yacinehrc/L-erreurscope/Images/Avancées/Projet/assemblage_boite.jpg

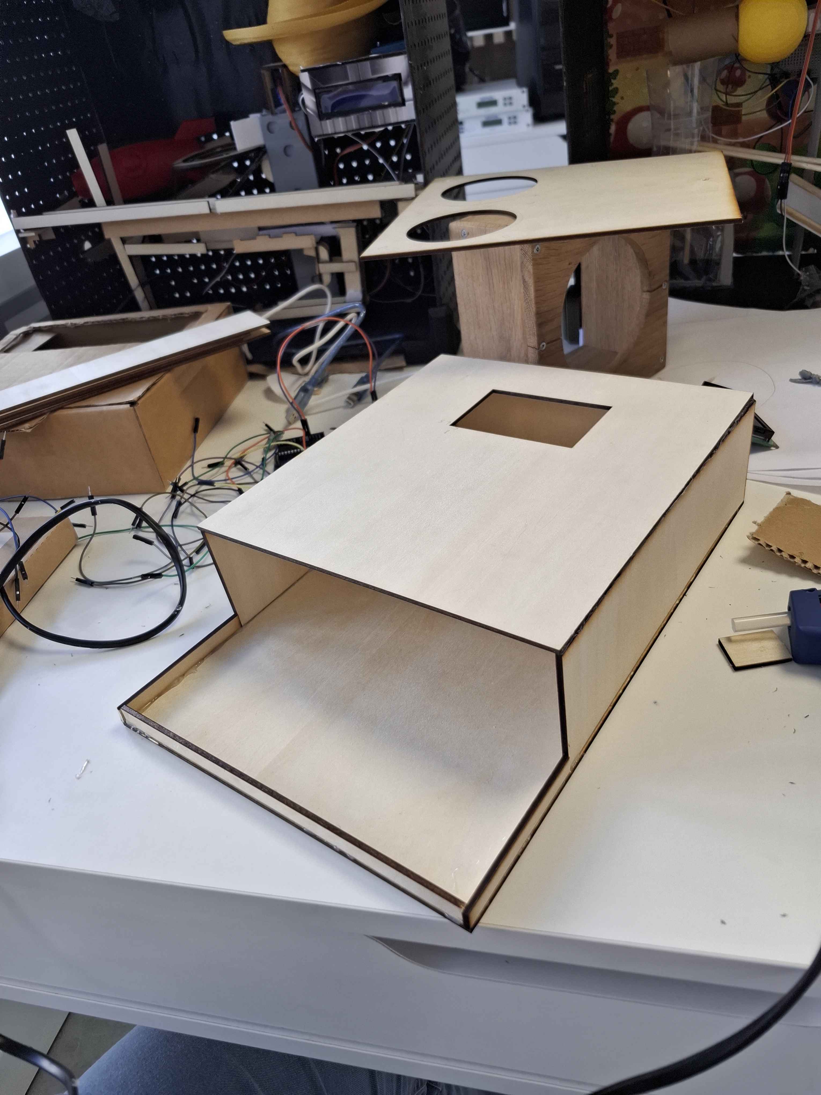
Images/Avancées/Projet/assemblage_boite.jpg
