yacinehrc/L-erreurscope/Images/Avancées/Projet/architecture_boite.jpg

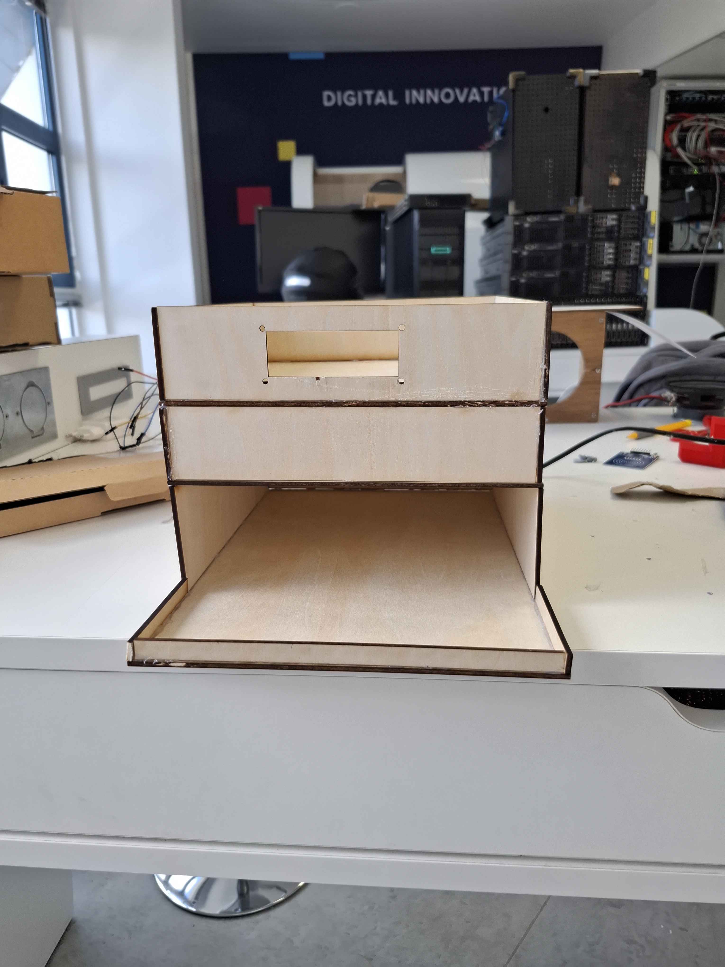
Images/Avancées/Projet/architecture_boite.jpg
