yacinehrc/L-erreurscope/Documentation/Dimensions - Boîte.pdf

Cyril P. Gauthier B. Louis A. Théo B. Yacine H.

L’erreurscope | Workshop B2 - EPSI Lille

# DIMENSION DE LA BOÎTE

## Sommaire

Introduction | 3
1. Étage 1 | 4
1.1 Surface | 4
1.2 Contours (L) | 4
1.3 Contours (l) | 5
2. Étage 2 | 6
2.1 Surface | 6
2.2 Contours (l) | 6
3. Étage 3 | 7
3.1 Surface | 7
3.2 Contours (L) | 7
3.3 Contours (l) | 7
4. Étage 4 | 9
4.1 Surface | 9
4.2 Contours (L) | 9
4.3 Contours (l) | 9
5. Autres | 11
5.1 Levier du servomoteur | 11
5.2 Découpe pour les hauts-parleur | 11
5.3 Découpe pour les composants | 11
5.4 Trou de fixation au servomoteur | 12
5.5 Trou pour l’écran LCD | 12
5.6 Trous pour les vis de l’écran | 13

## Introduction

Cette documentation détaille les dimensions de la boîte en balsa (0,3 cm d'épaisseur), découpée au laser au myDiL. Les plans ont été optimisés pour minimiser les pertes de matière, les chutes étant conservées pour de futurs ajustements. À noter que le document n'inclut que les perçages réalisés au laser, hors éventuelles retouches manuelles au cutter.

## 1. Étage 1

1.1 Surface

Nombre : 1
Longueur : 31 cm
Largeur : 21 cm

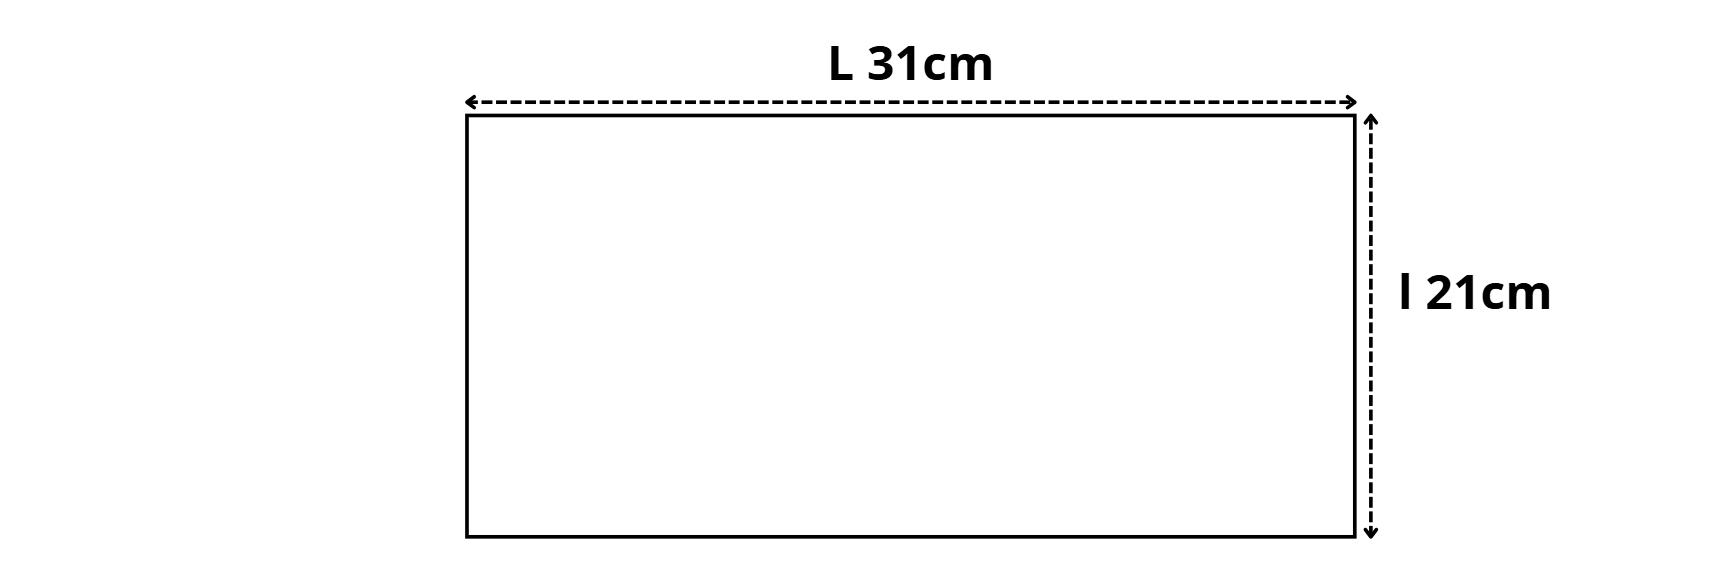
[picture p24: figure]

1.2 Contours (L)

Nombre : 2
Longueur : 8 cm
Hauteur : 1 cm

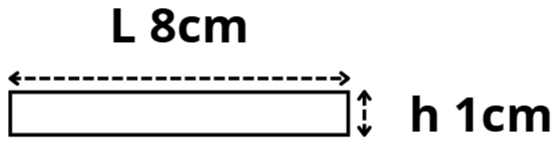
[picture p25: figure]

Nombre : 2
Longueur : 23 cm
Hauteur : 6.6 cm

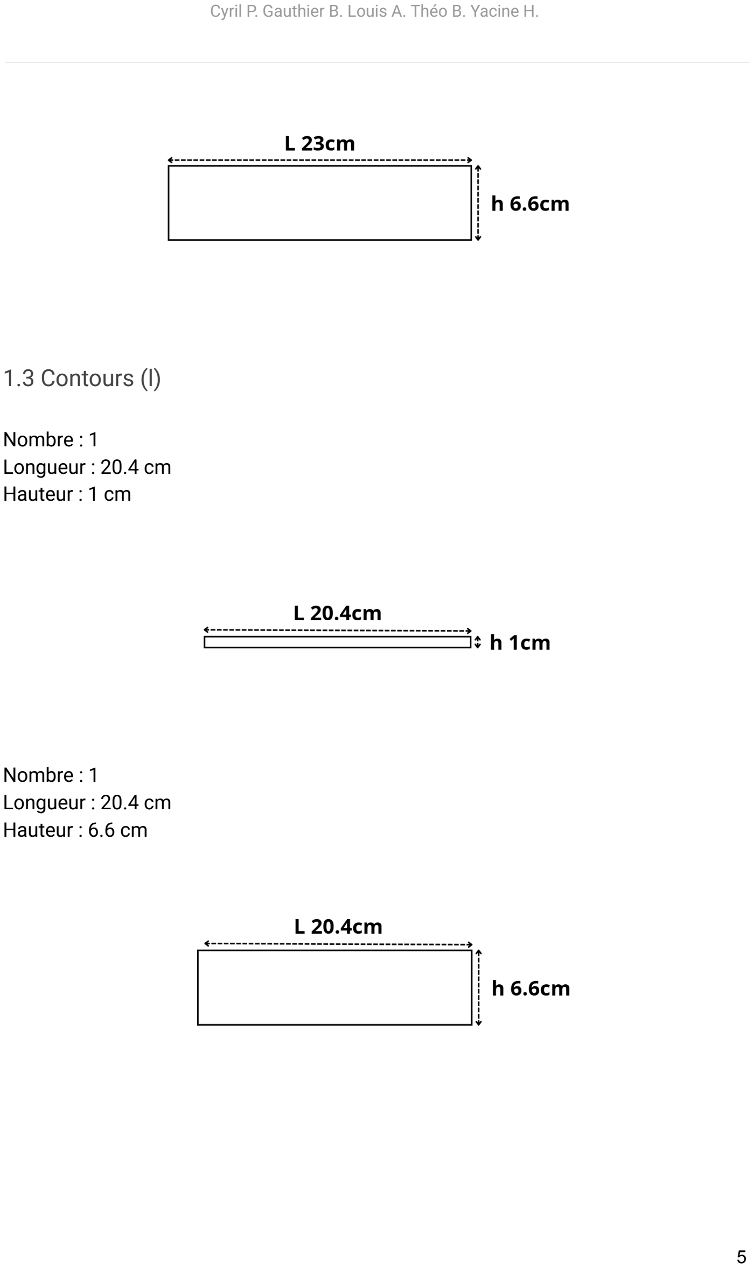
[picture p26: page 5]

1.3 Contours (l)

Nombre : 1
Longueur : 20.4 cm
Hauteur : 1 cm

Nombre : 1
Longueur : 20.4 cm
Hauteur : 6.6 cm

## 2. Étage 2

2.1 Surface

Nombre : 1
Longueur : 21 cm
Largeur : 8.3 cm

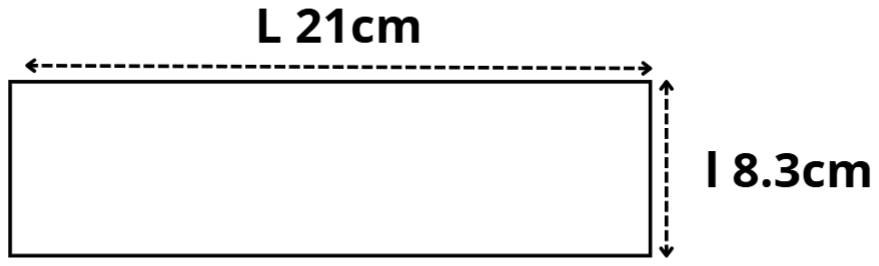
[picture p27: figure]

2.2 Contours (l)

Nombre : 1
Longueur : 21.3 cm
Hauteur : 5 cm

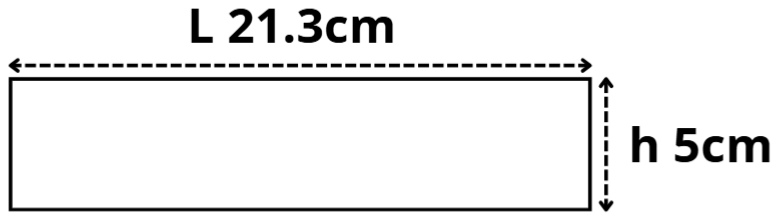
[picture p28: figure]

## 3. Étage 3

3.1 Surface

Nombre : 1
Longueur : 23 cm
Largeur : 21 cm

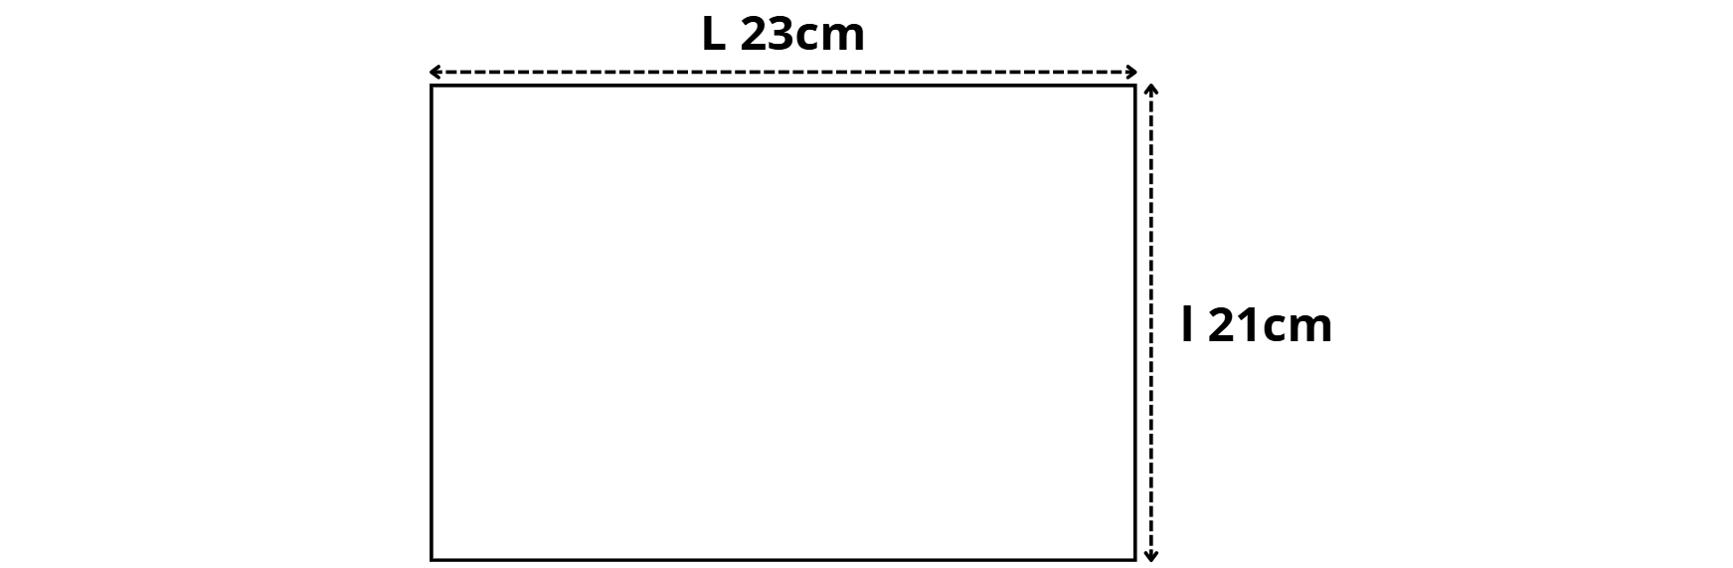
[picture p29: figure]

3.2 Contours (L)

Nombre : 2
Longueur : 23 cm
Hauteur : 5 cm

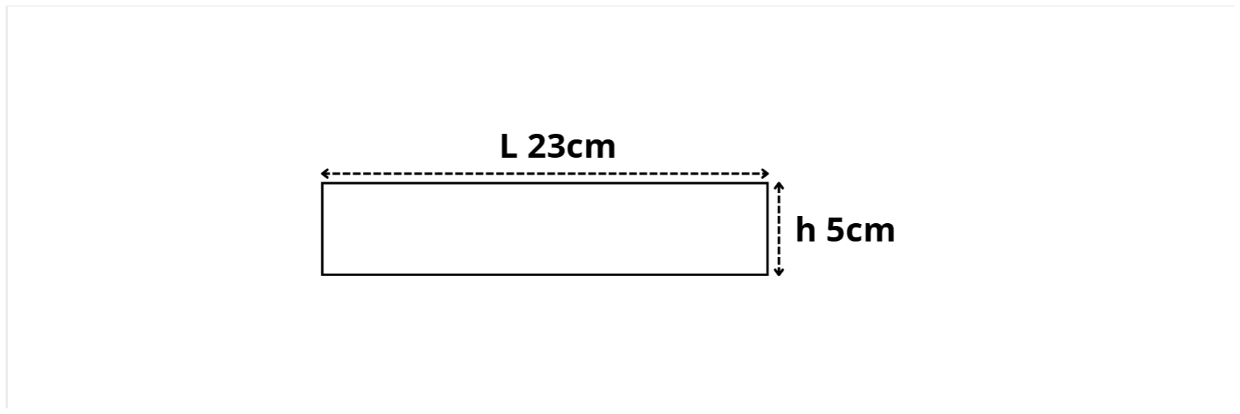
[picture p30: figure]

3.3 Contours (l)

Nombre : 2
Longueur : 20.4 cm
Hauteur : 5 cm

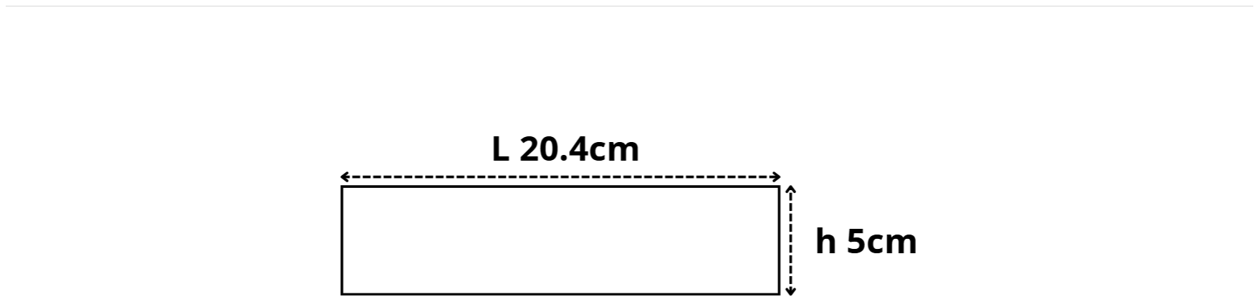
[picture p31: figure]

## 4. Étage 4

4.1 Surface

Nombre : 2
Longueur : 23 cm
Largeur : 21 cm

4.2 Contours (L)

Nombre : 2
Longueur : 23 cm
Hauteur : 4.2 cm

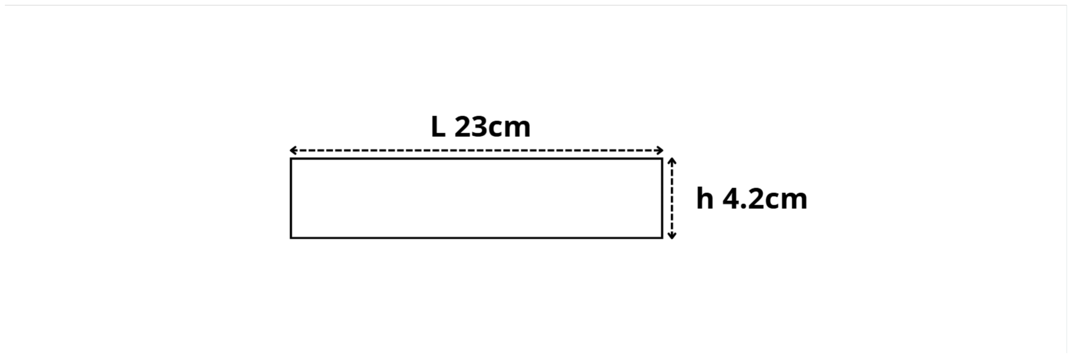
[picture p32: figure]

4.3 Contours (l)

Nombre : 2
Longueur : 20.4 cm
Hauteur : 4.2 cm

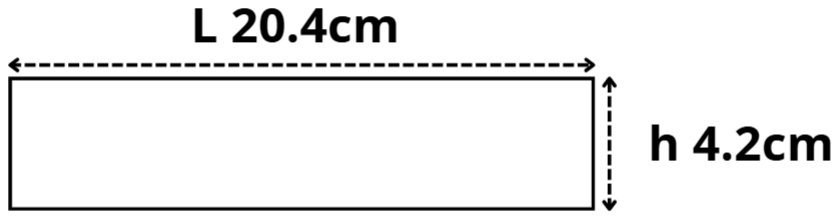
[picture p33: figure]

### 5. Autres

5.1 Levier du servomoteur

Nombre : 1
Longueur : 14.1 cm
Hauteur : 0.7 cm

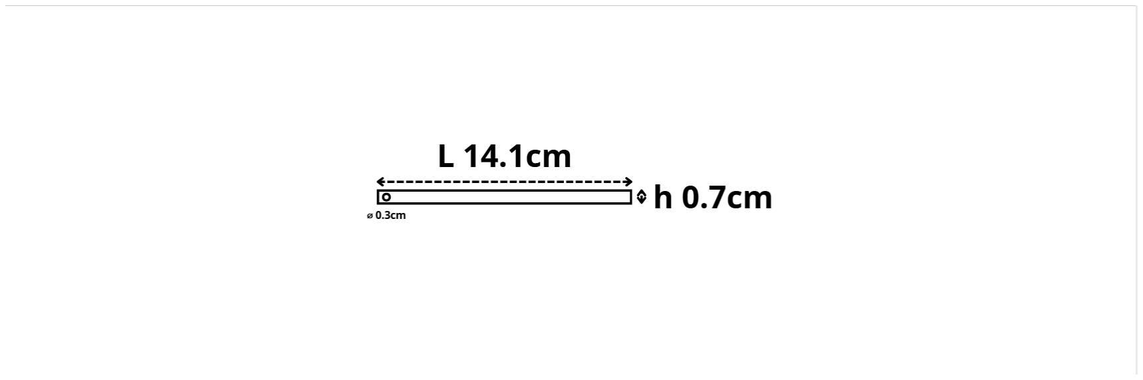
[picture p34: figure]

5.2 Découpe pour les hauts-parleur

Nombre : 2
Diamètre : 7.5cm

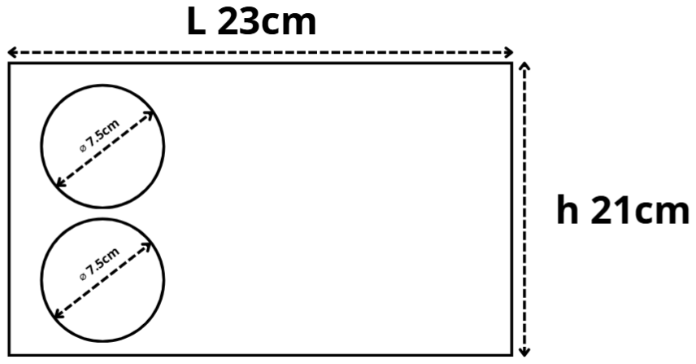
[picture p35: figure]

5.3 Découpe pour les composants

Nombre : 1
Longueur : 8 cm
Largeur : 5 cm

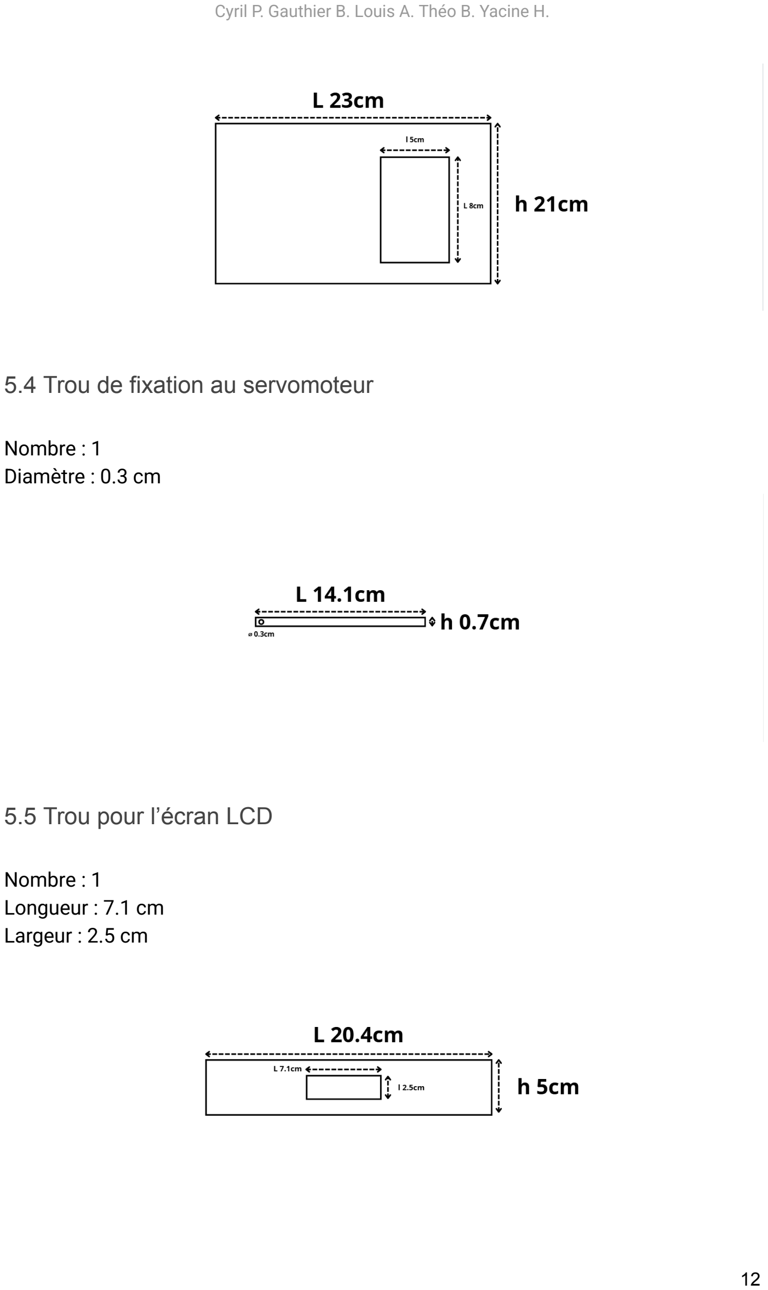
[picture p36: page 12]

5.4 Trou de fixation au servomoteur

Nombre : 1
Diamètre : 0.3 cm

5.5 Trou pour l’écran LCD

Nombre : 1
Longueur : 7.1 cm
Largeur : 2.5 cm

5.6 Trous pour les vis de l’écran

Nombre : 4
Diamètre : 0.3 cm

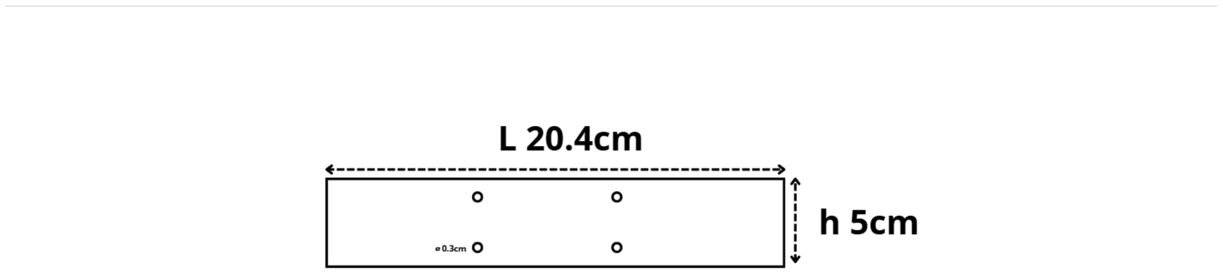
[picture p37: figure]
