yacinehrc/L-erreurscope/Images/Avancées/Projet/boite_finale.jpg

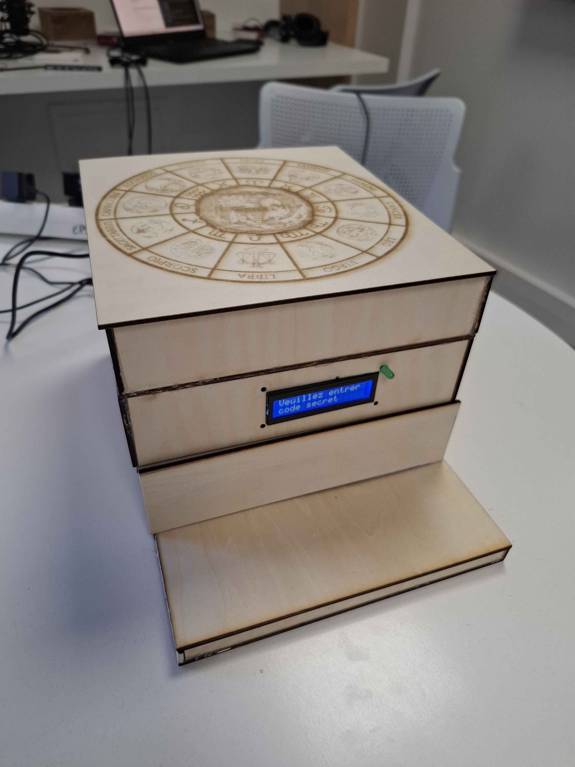
Images/Avancées/Projet/boite_finale.jpg
