yacinehrc/L-erreurscope/Images/Avancées/Projet/boite_visuel_dessus.jpg

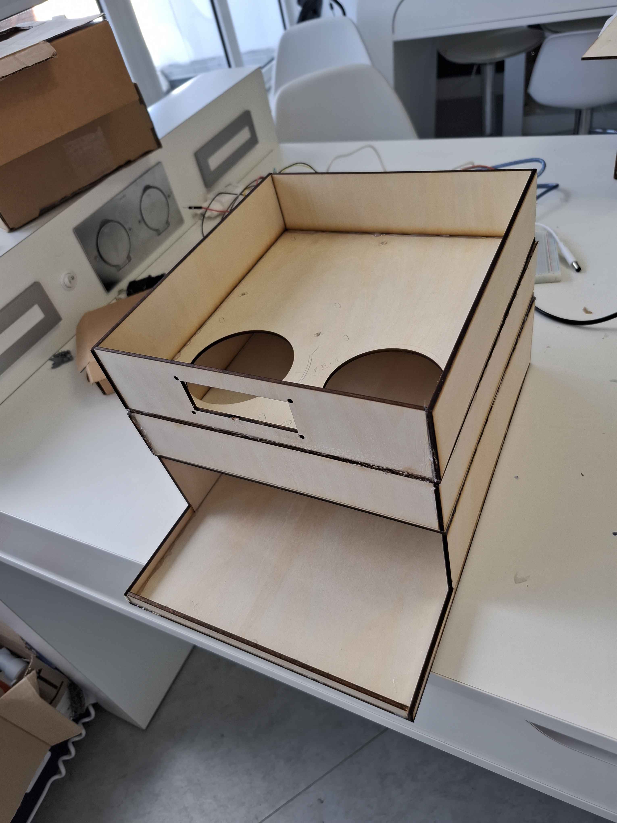
Images/Avancées/Projet/boite_visuel_dessus.jpg
