yacinehrc/L-erreurscope/Images/Avancées/Projet/collage_bois.jpg

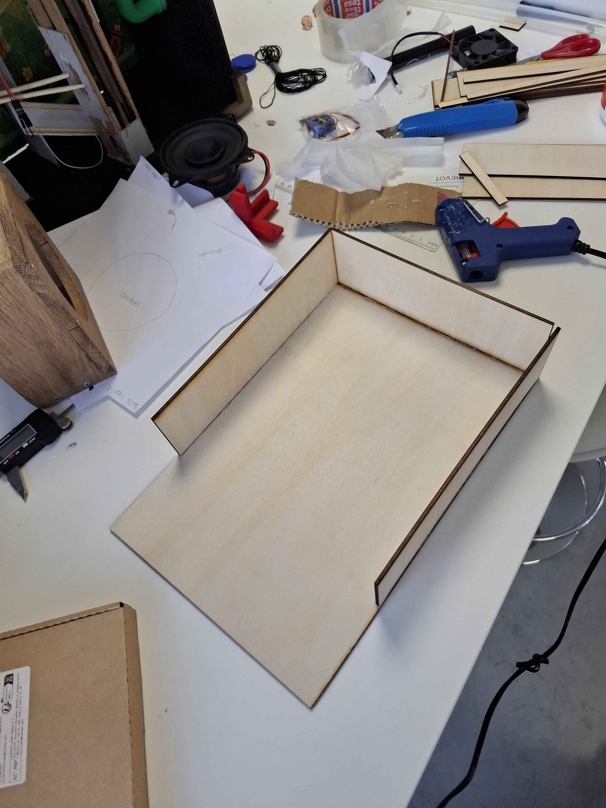
Images/Avancées/Projet/collage_bois.jpg
