yacinehrc/L-erreurscope/Images/Avancées/Projet/decoupe_bois.jpg

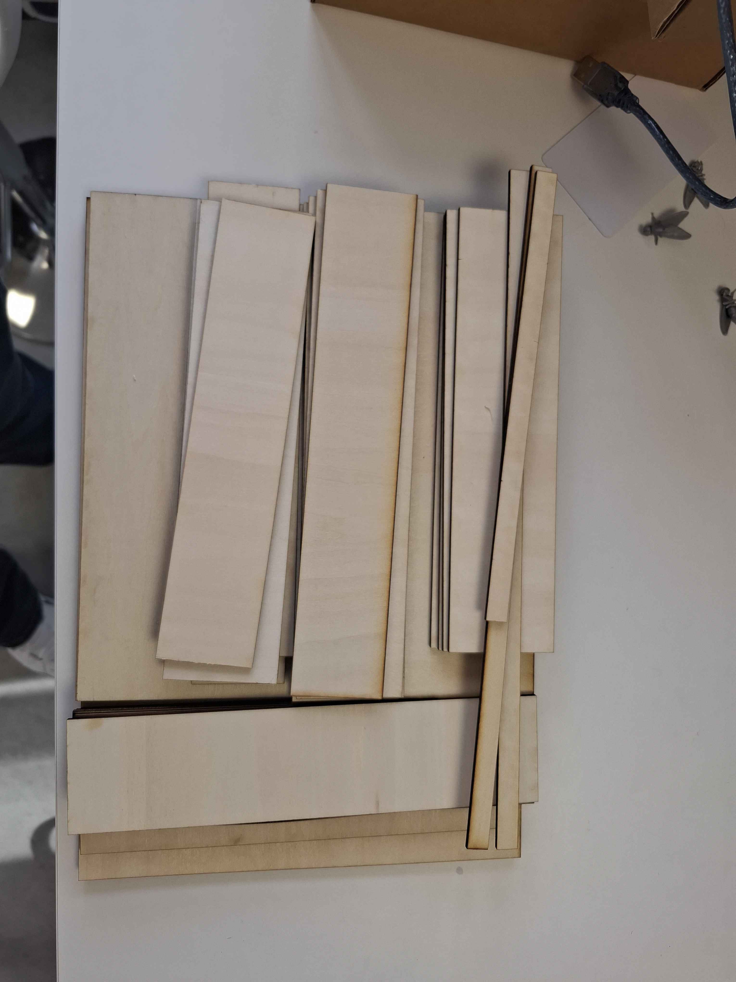
Images/Avancées/Projet/decoupe_bois.jpg
