yacinehrc/L-erreurscope/Images/Avancées/Projet/prototype_boite.jpg

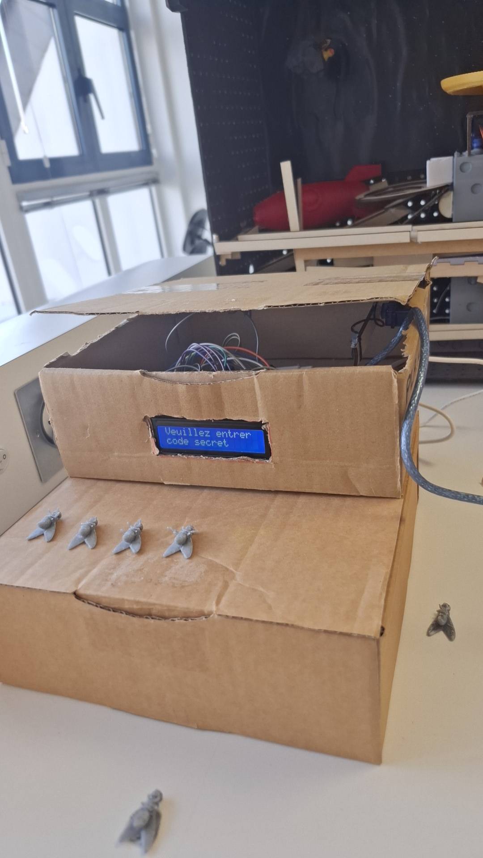
Images/Avancées/Projet/prototype_boite.jpg
