yacinehrc/L-erreurscope/Images/Avancées/Projet/prototype_boite_ouverte.jpg

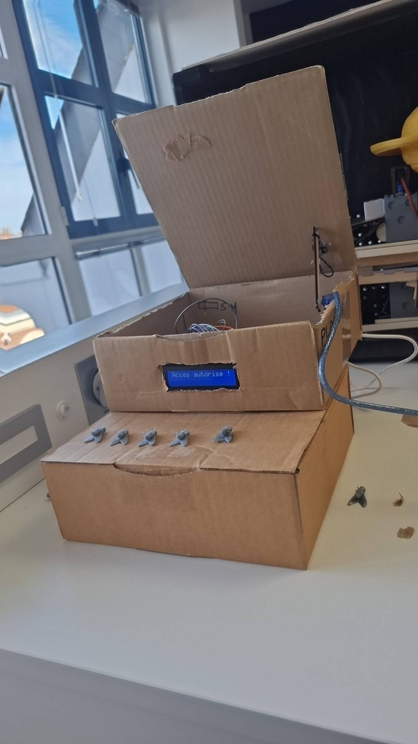
Images/Avancées/Projet/prototype_boite_ouverte.jpg
