yacinehrc/L-erreurscope/Images/Avancées/Tableau Blanc/boite_couches.jpg

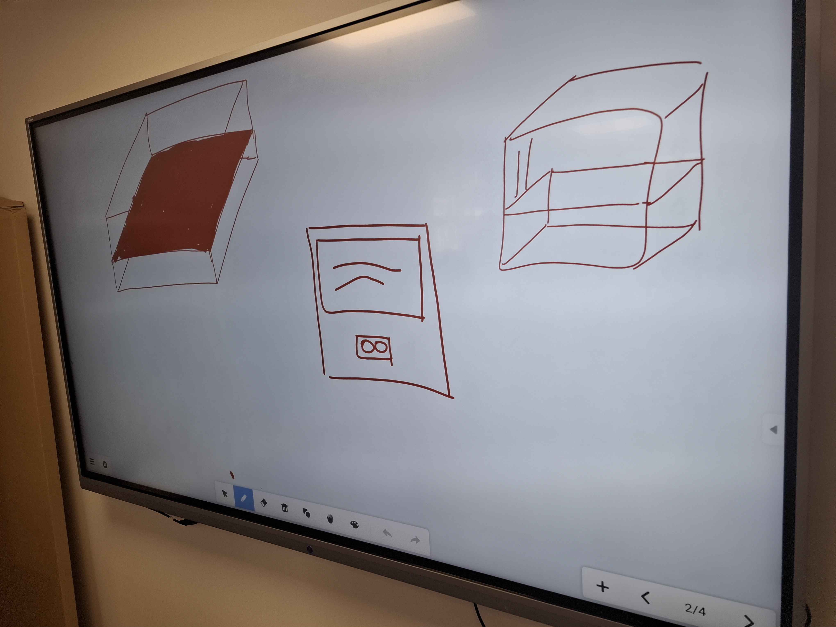
Images/Avancées/Tableau Blanc/boite_couches.jpg
