yacinehrc/L-erreurscope/Images/Avancées/Tableau Blanc/brainstorming_jeudi.jpg

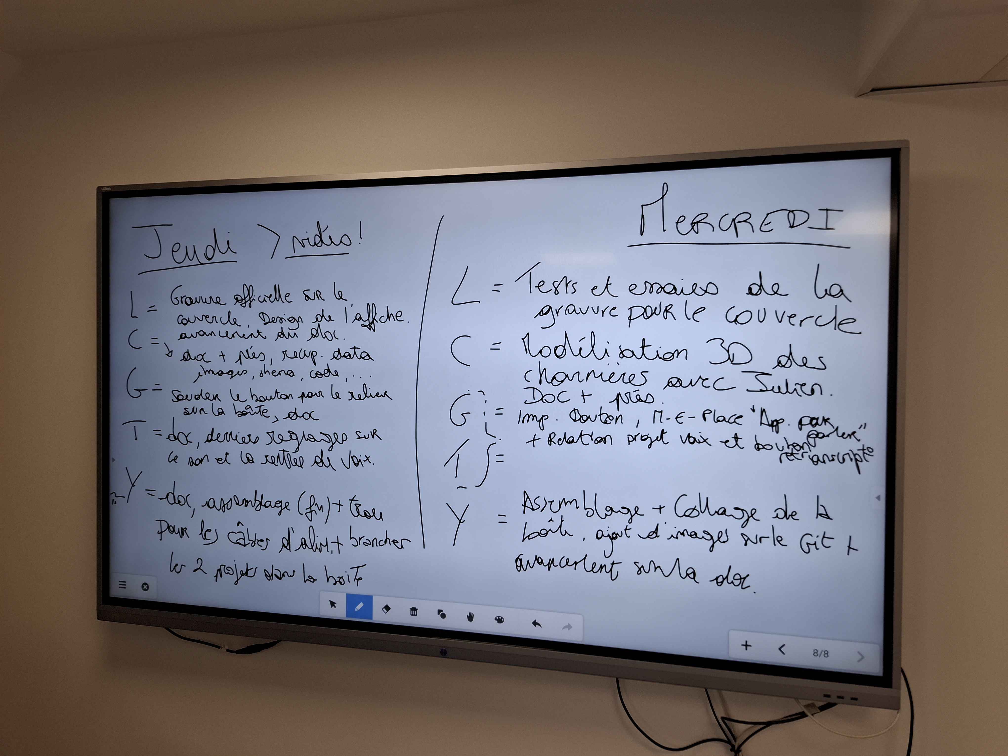
Images/Avancées/Tableau Blanc/brainstorming_jeudi.jpg
