yacinehrc/L-erreurscope/Images/Avancées/Tableau Blanc/brainstorming_mardi.jpg

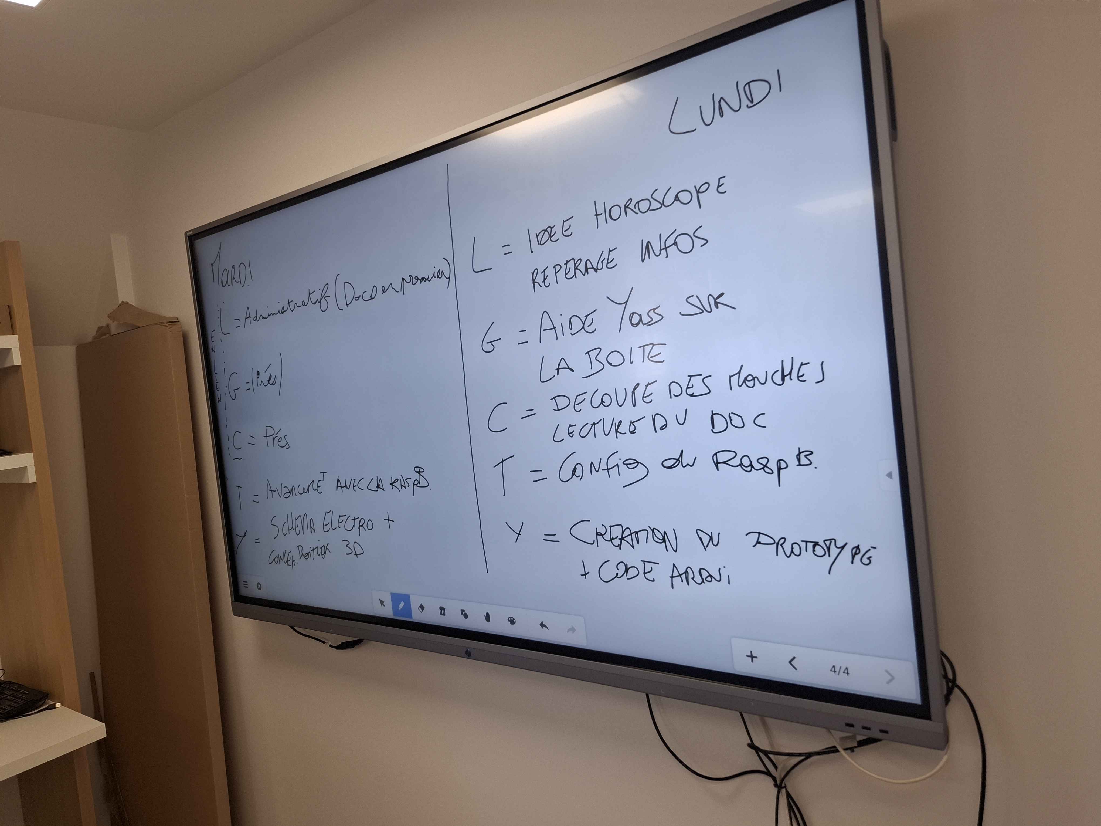
Images/Avancées/Tableau Blanc/brainstorming_mardi.jpg
