yacinehrc/L-erreurscope/Images/Avancées/Tableau Blanc/brainstorming_mercredi.jpg

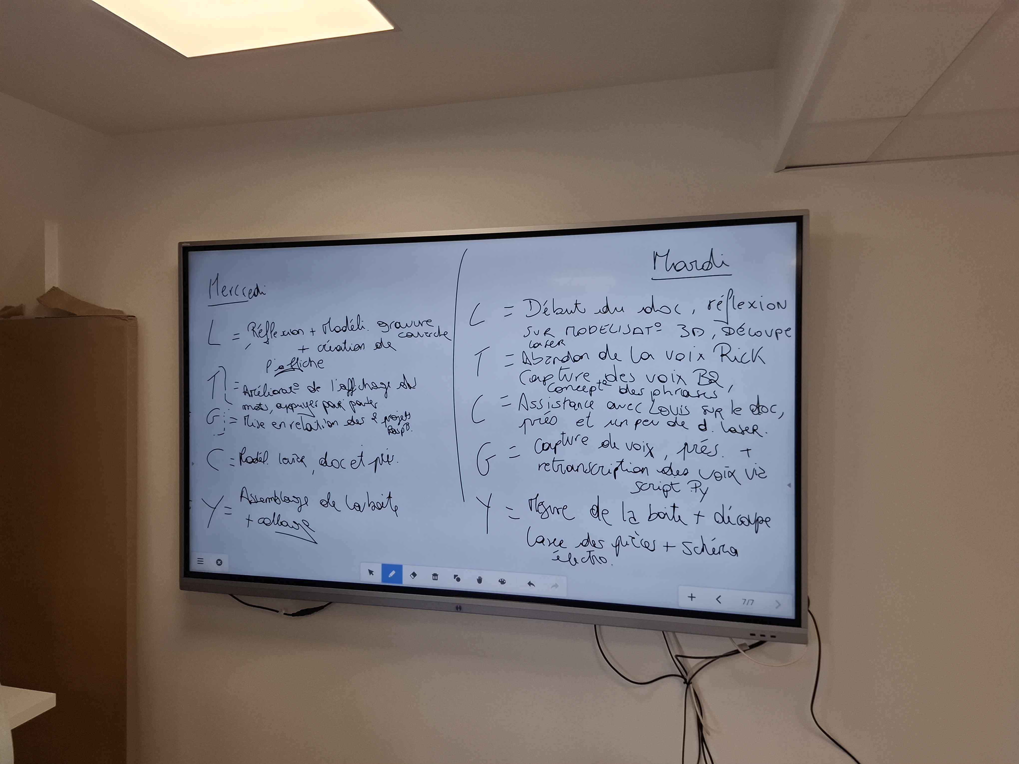
Images/Avancées/Tableau Blanc/brainstorming_mercredi.jpg
