yacinehrc/L-erreurscope/Images/Avancées/Tableau Blanc/mesures_boite.jpg

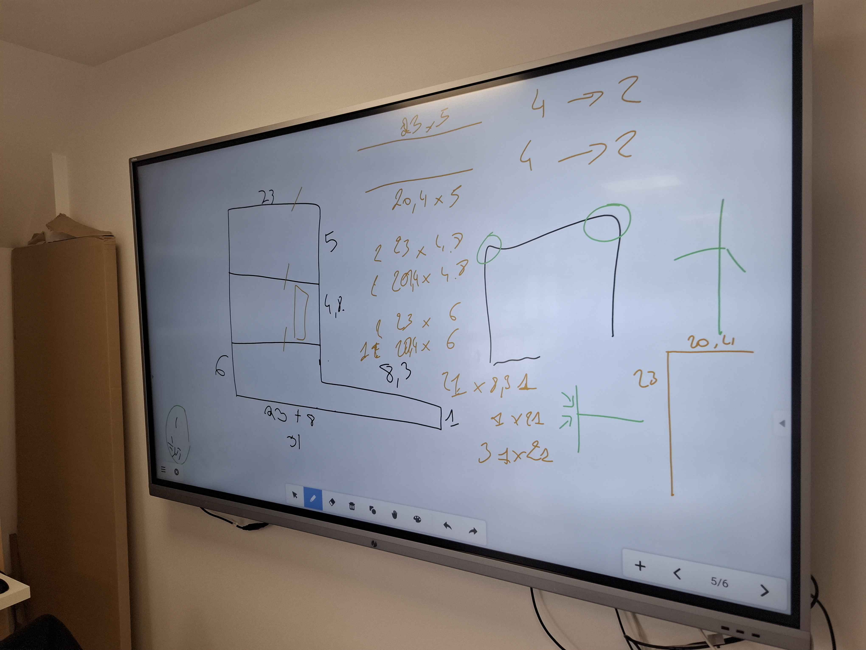
Images/Avancées/Tableau Blanc/mesures_boite.jpg
