yacinehrc/L-erreurscope/Images/Avancées/Tableau Blanc/modelisation_3D.jpg

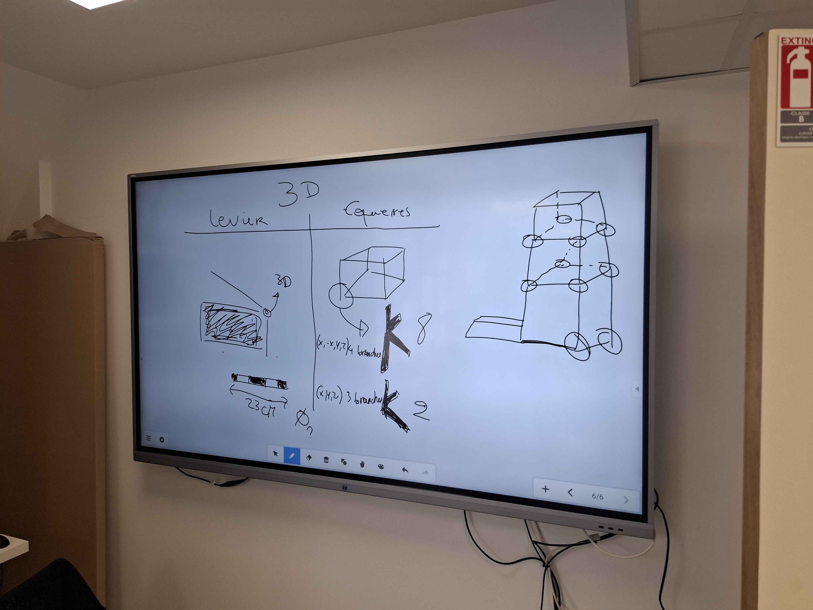
Images/Avancées/Tableau Blanc/modelisation_3D.jpg
