yacinehrc/L-erreurscope/Images/Avancées/Tableau Blanc/prototype_boite.jpg

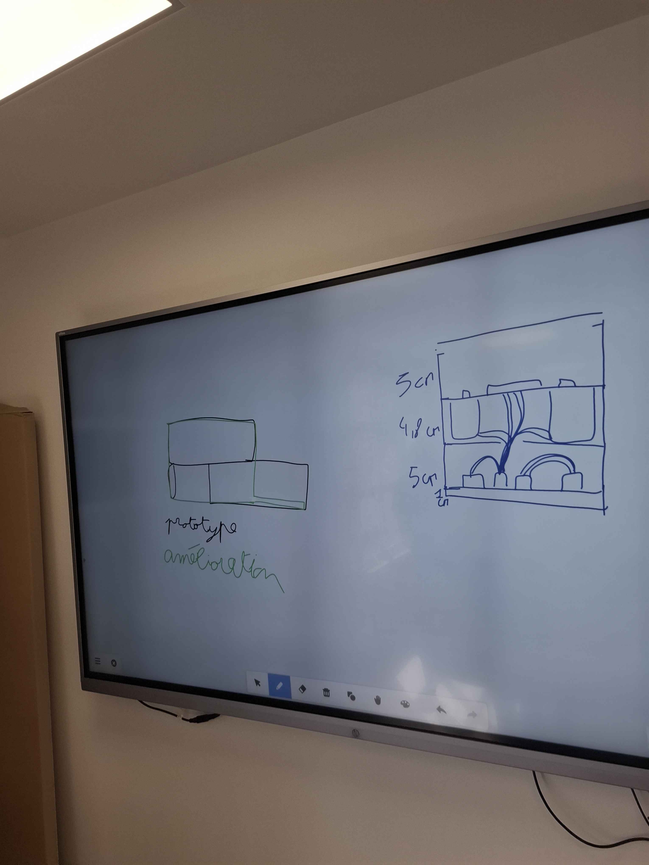
Images/Avancées/Tableau Blanc/prototype_boite.jpg
