yacinehrc/L-erreurscope/Images/Code/Arduino/loop_fermeture.png

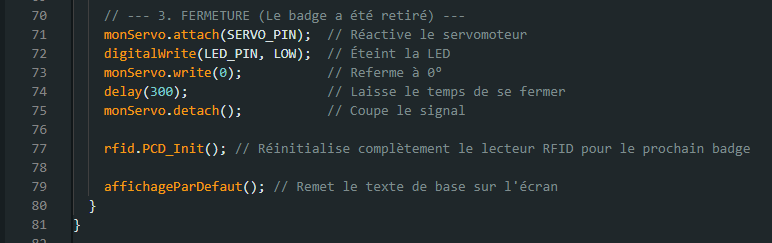
Images/Code/Arduino/loop_fermeture.png
