yacinehrc/L-erreurscope/Images/Erreurscope/Affiche_Erreurscope.jpg

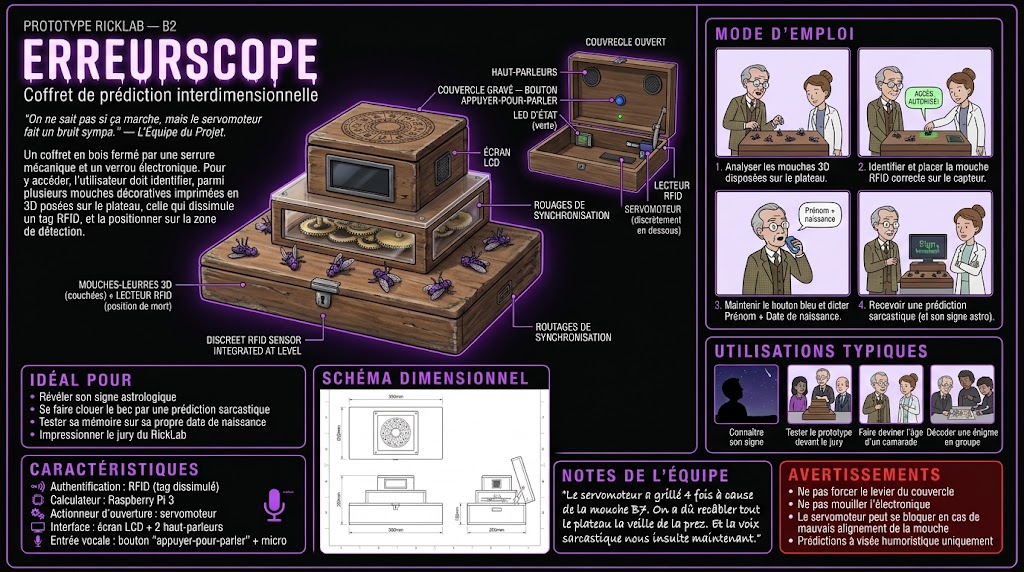
Images/Erreurscope/Affiche_Erreurscope.jpg
