yacinehrc/L-erreurscope/Images/Erreurscope/erreurscope_img.jpg

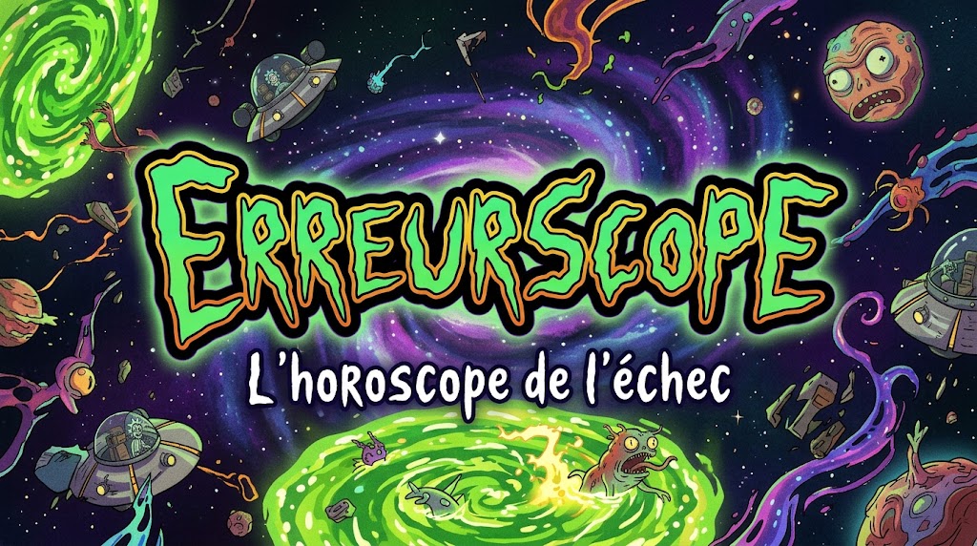
Images/Erreurscope/erreurscope_img.jpg
