yacinehrc/L-erreurscope/Images/Mesures/Autres/decoupe 8x5 cm.png

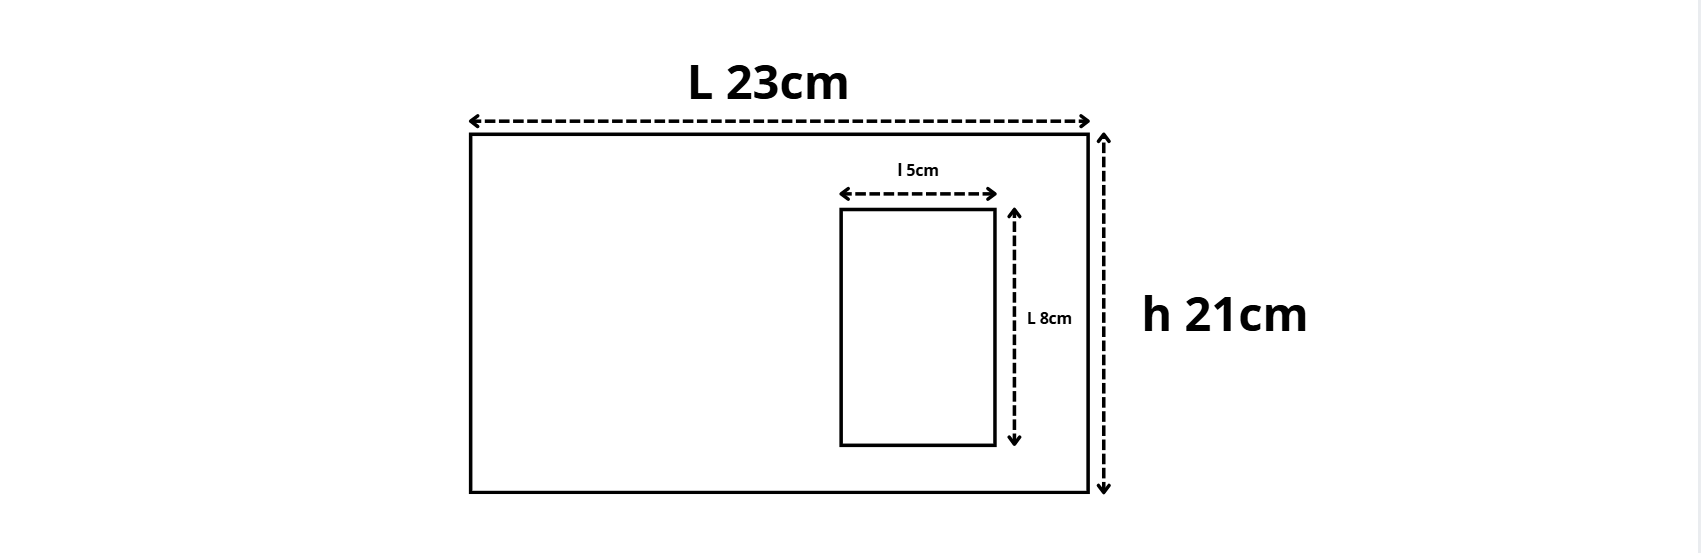
Images/Mesures/Autres/decoupe 8x5 cm.png
