yacinehrc/L-erreurscope/Images/Mesures/Autres/diametre 7.5cm.png

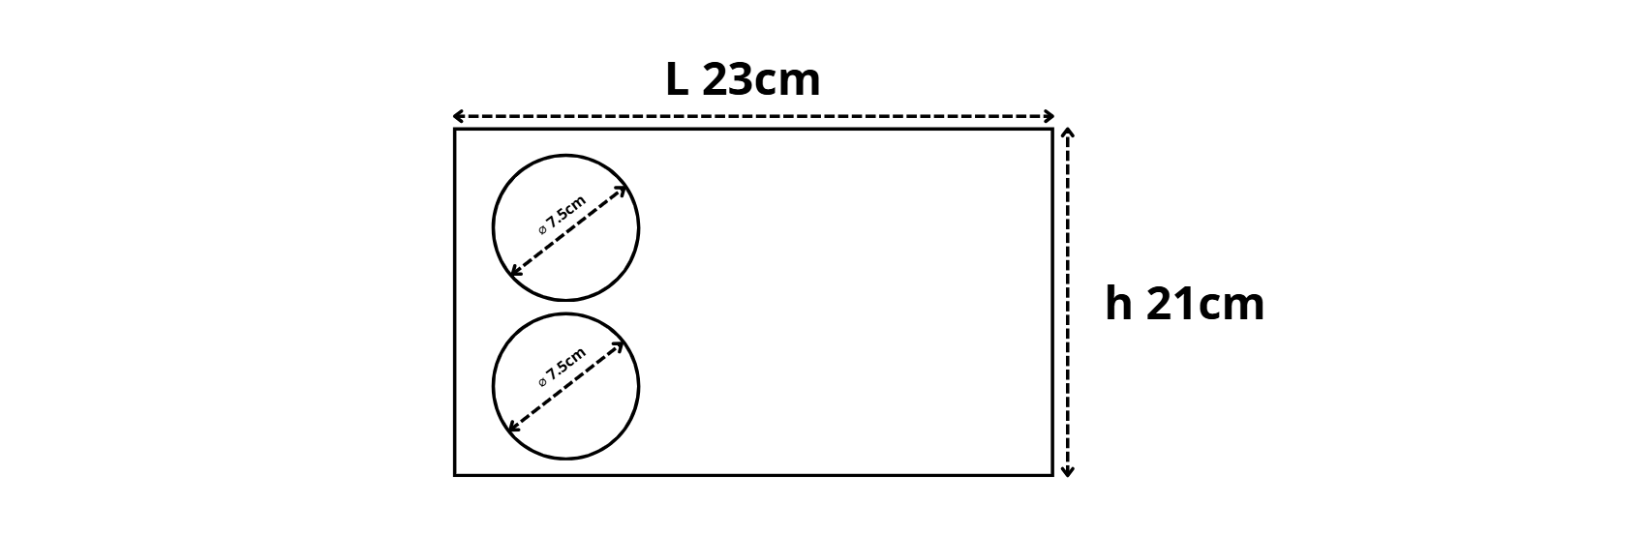
Images/Mesures/Autres/diametre 7.5cm.png
