yacinehrc/L-erreurscope/Images/Mesures/Etage_1/23x6.6 cm.png

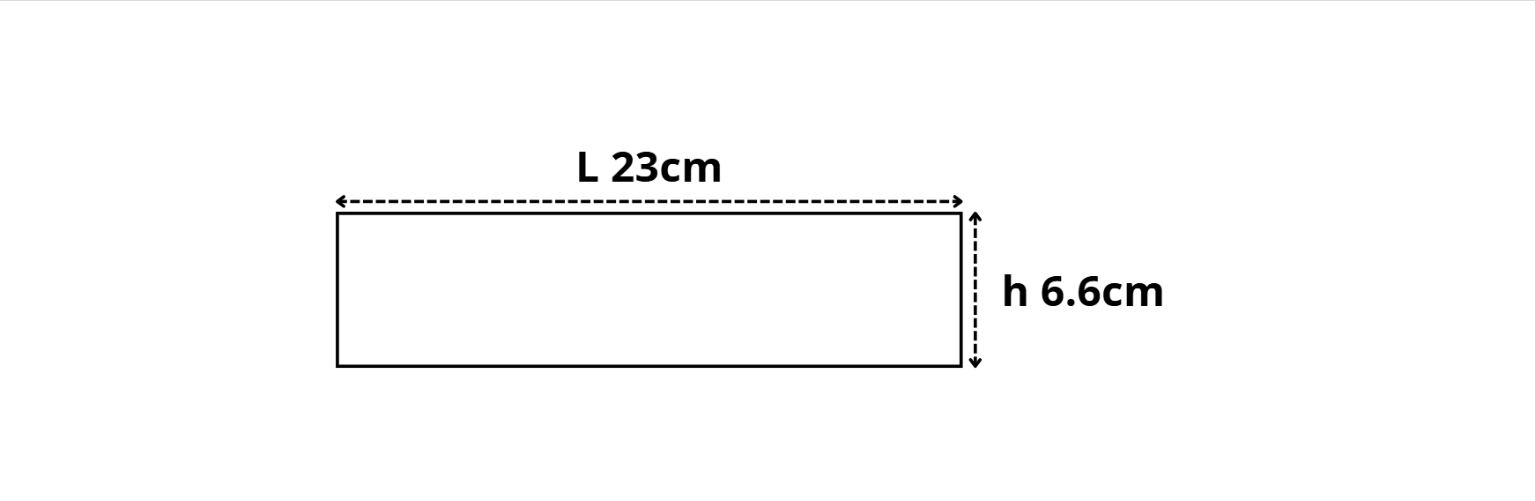
Images/Mesures/Etage_1/23x6.6 cm.png
