yacinehrc/L-erreurscope/Images/Modélisation/3D/boite_jeudi.jpg

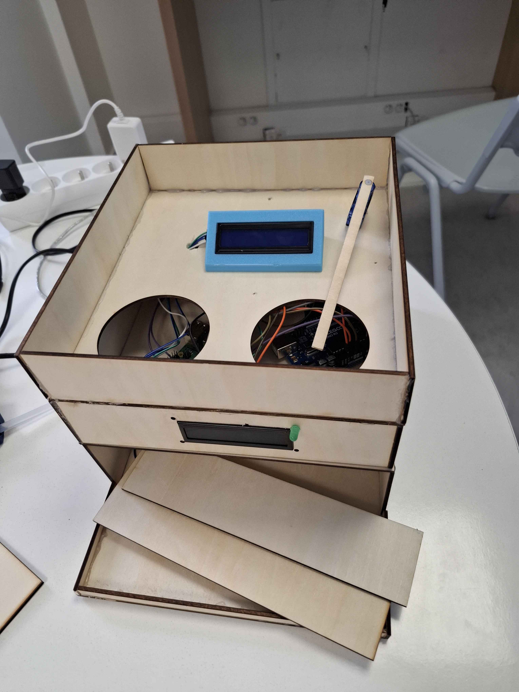
Images/Modélisation/3D/boite_jeudi.jpg
