yacinehrc/L-erreurscope/Images/Modélisation/3D/demi-charniere_3D.jpg

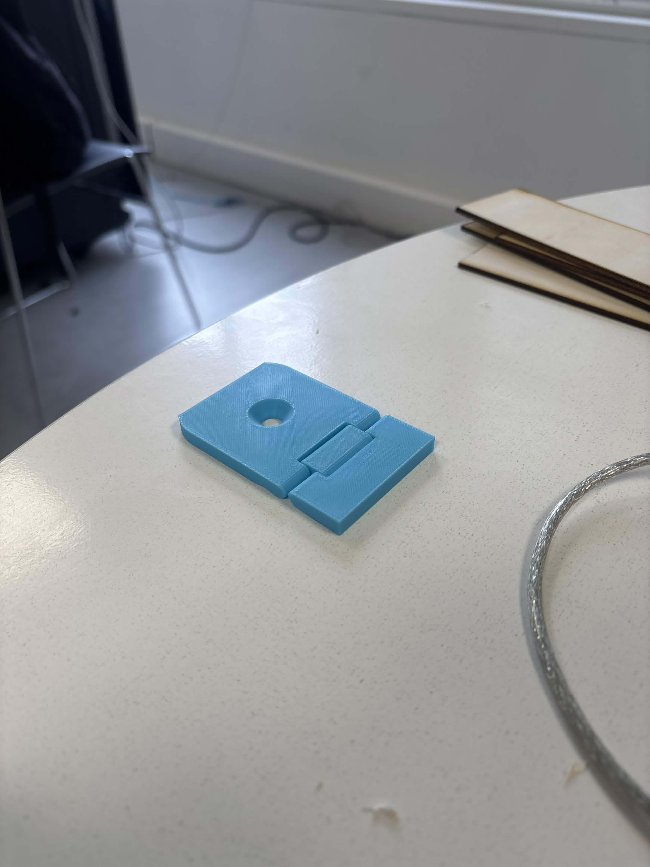
Images/Modélisation/3D/demi-charniere_3D.jpg
