yacinehrc/L-erreurscope/Images/Modélisation/3D/mouches_3D.jpg

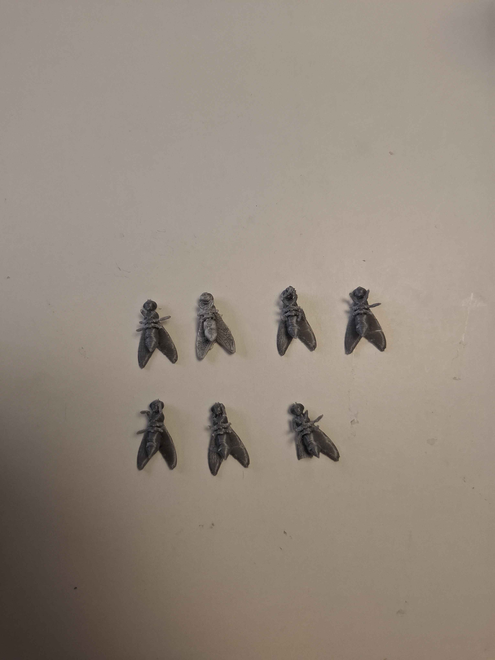
Images/Modélisation/3D/mouches_3D.jpg
