yacinehrc/L-erreurscope/Images/Modélisation/3D/support_ecran_3D.jpg

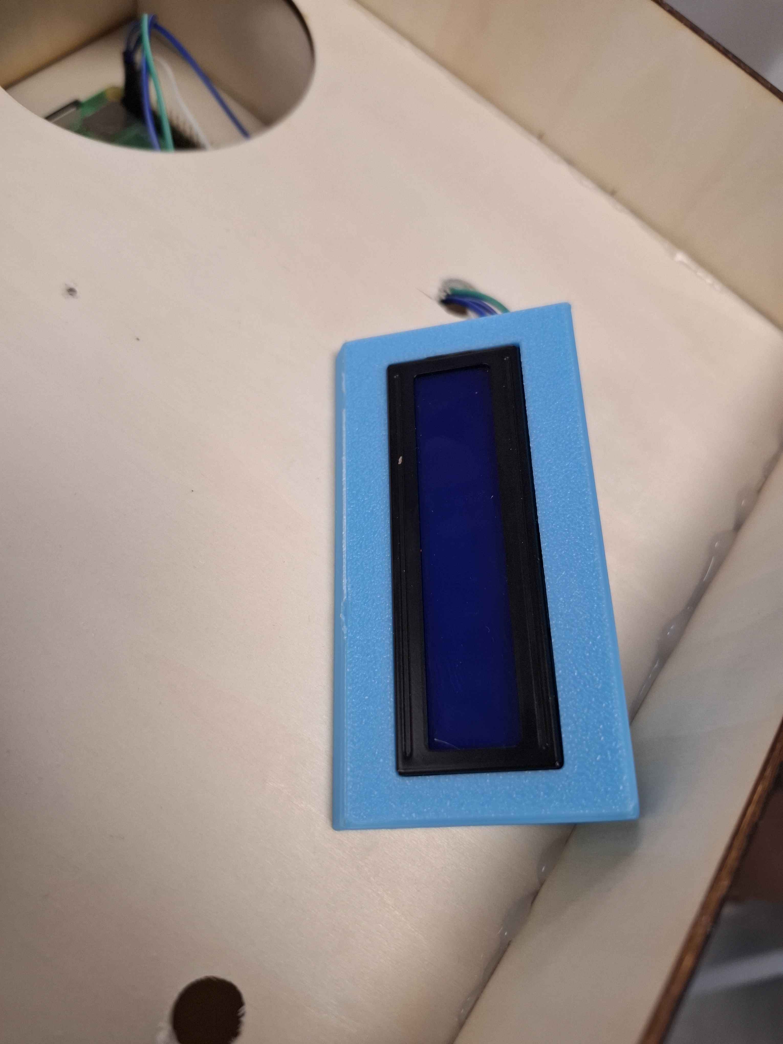
Images/Modélisation/3D/support_ecran_3D.jpg
