yacinehrc/L-erreurscope/Images/Modélisation/Gravure/gravure_couvercle.jpg

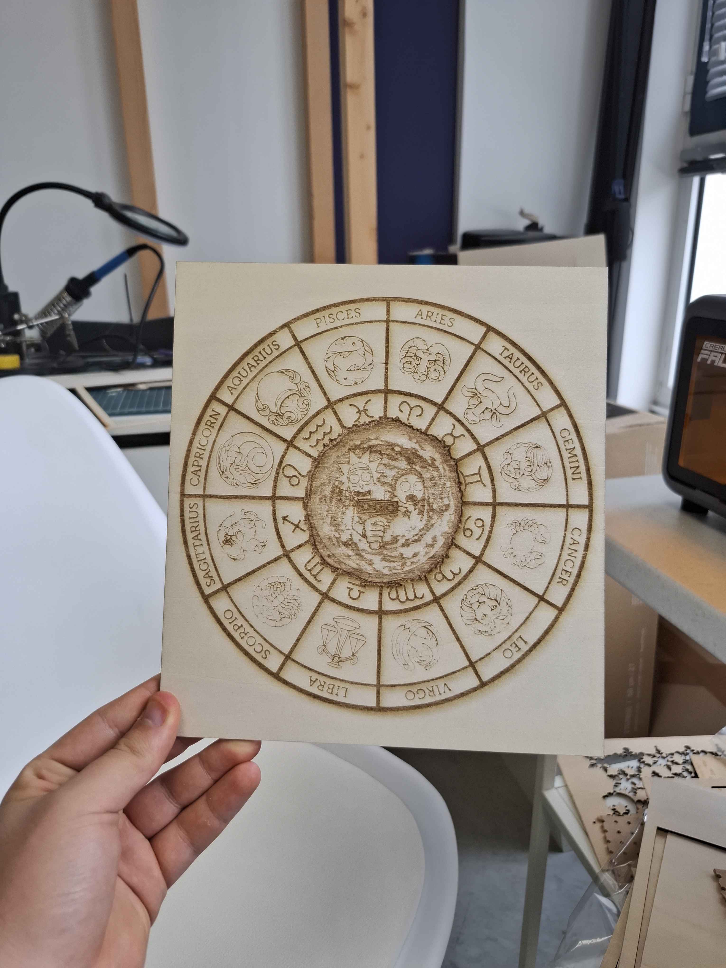
Images/Modélisation/Gravure/gravure_couvercle.jpg
