yacinehrc/L-erreurscope/Images/Schema/Boite/etage_1.png

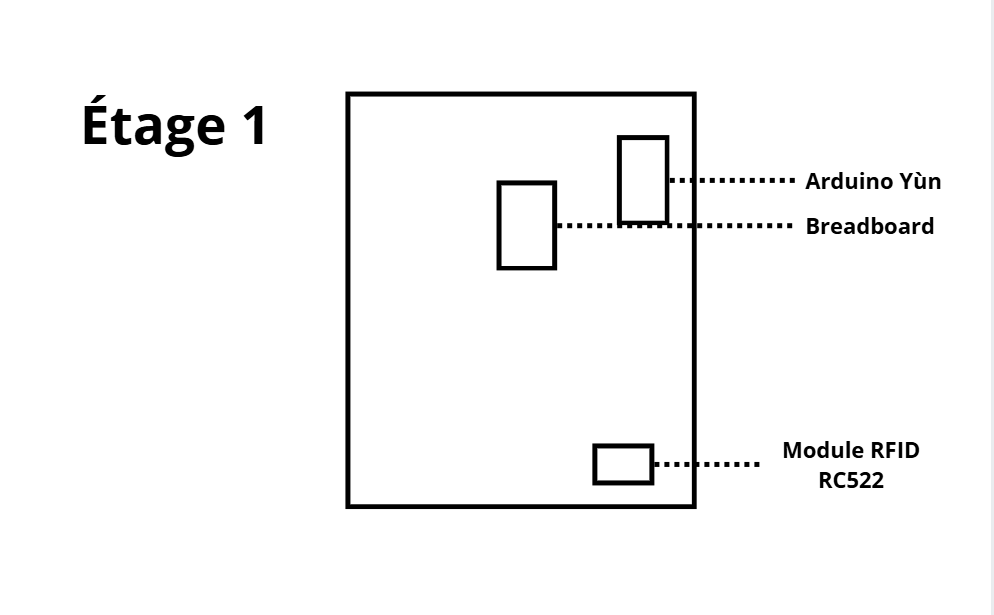
Images/Schema/Boite/etage_1.png
