yacinehrc/L-erreurscope/Images/Schema/Boite/etage_3.png

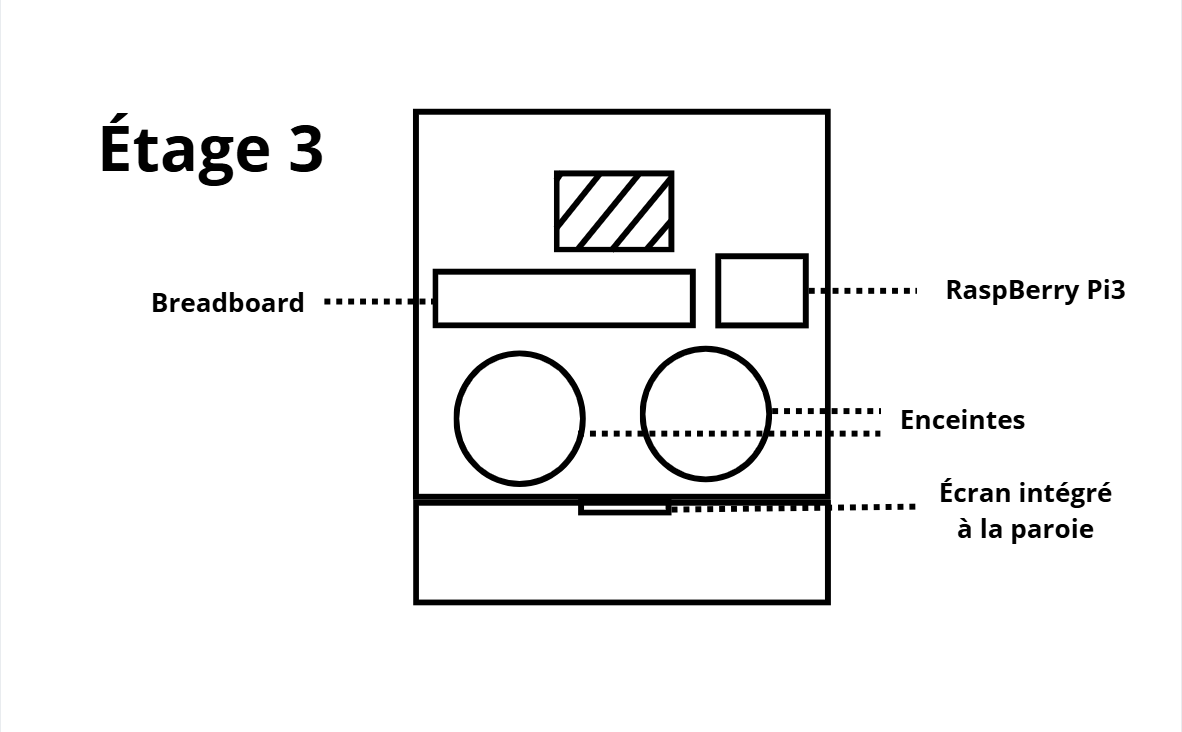
Images/Schema/Boite/etage_3.png
