yacinehrc/L-erreurscope/Images/Schema/Boite/etage_4.png

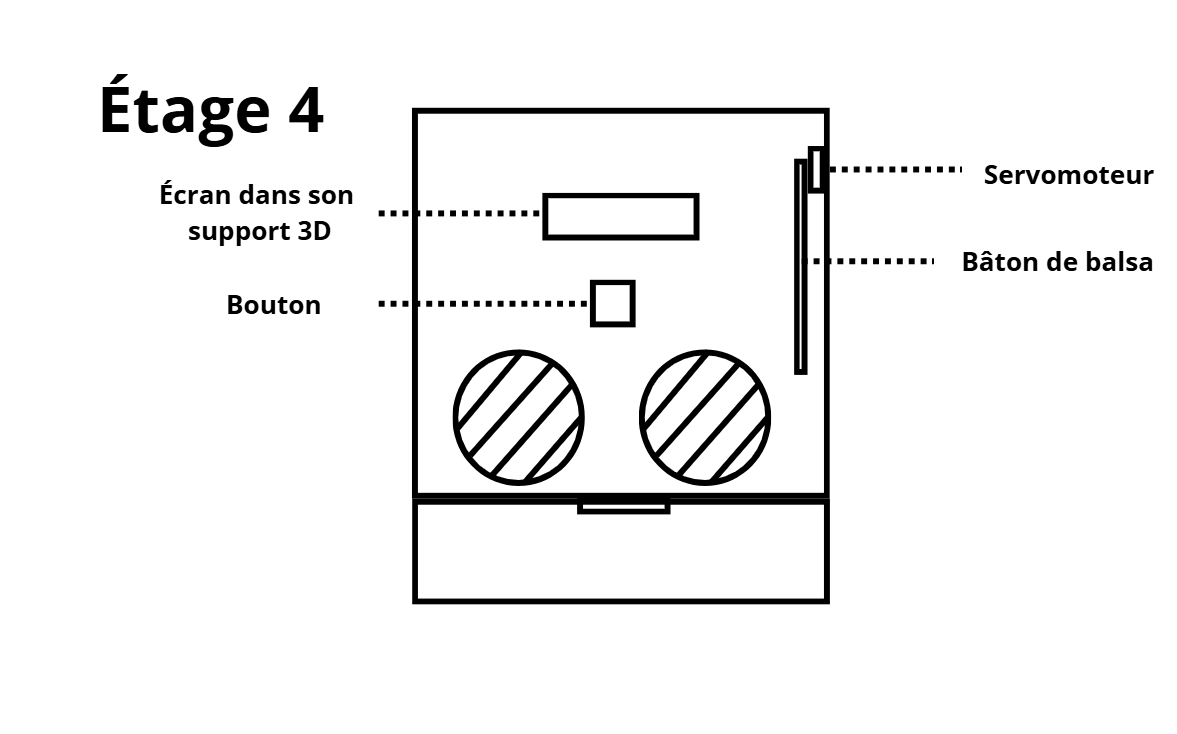
Images/Schema/Boite/etage_4.png
