yacinehrc/L-erreurscope/Images/Schema/Boite/schema_boite_portrait_face.png

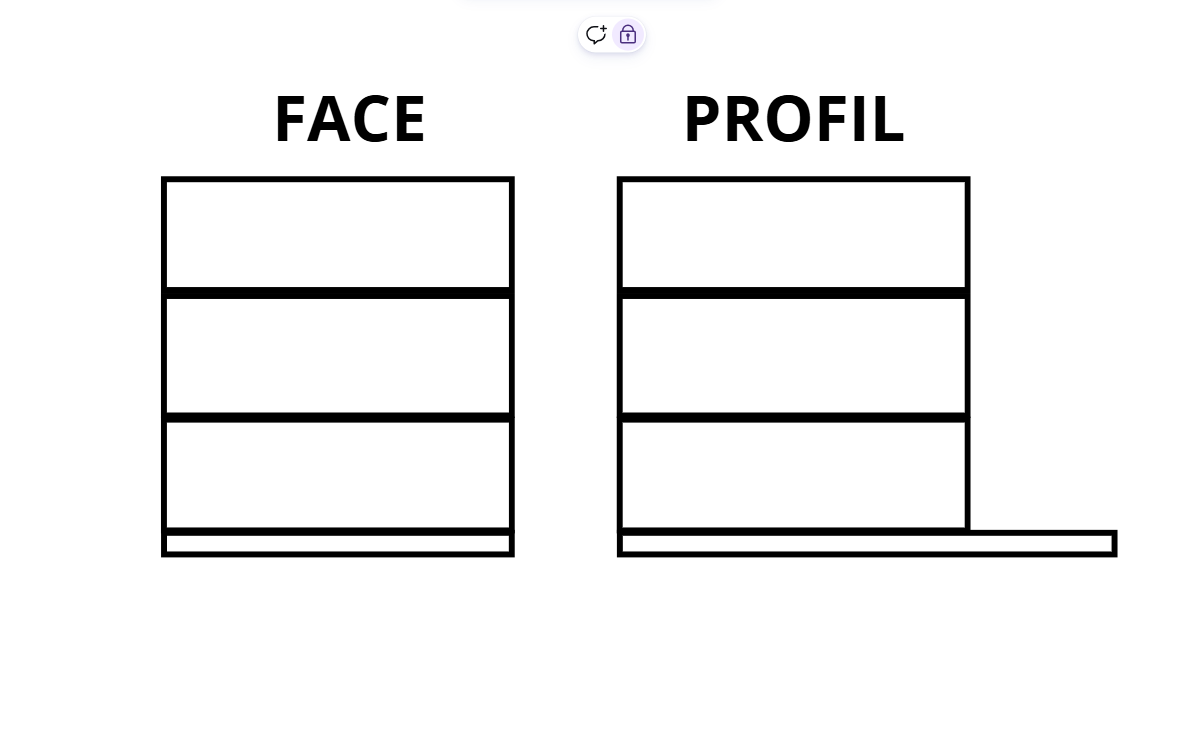
Images/Schema/Boite/schema_boite_portrait_face.png
