yacinehrc/L-erreurscope/Images/Schema/Electronique_ouverture/schema.png

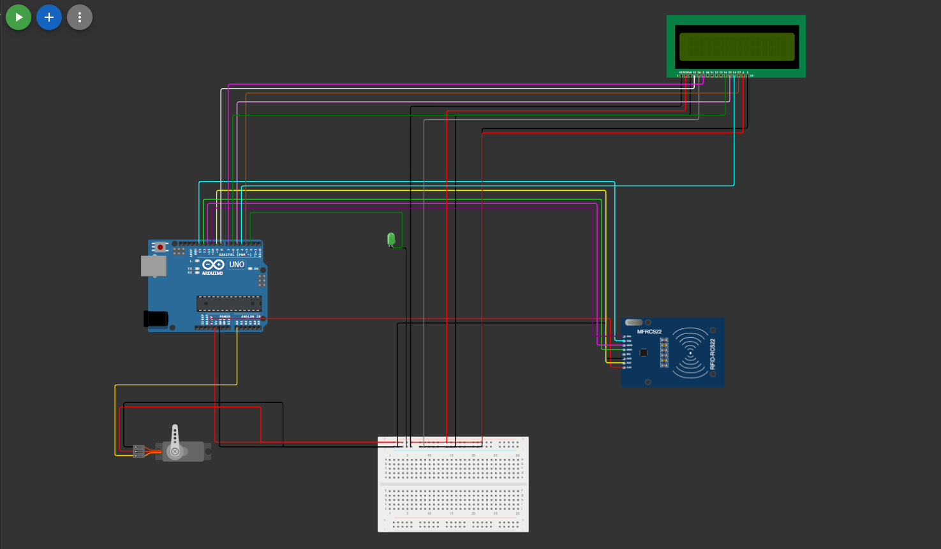
Images/Schema/Electronique_ouverture/schema.png
