yacinehrc/L-erreurscope/Images/Schema/Electronique_ouverture/schema_Arduino.png

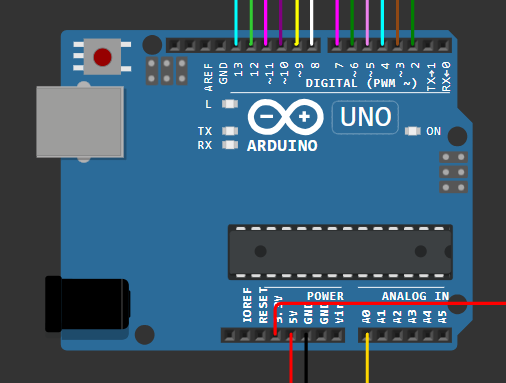
Images/Schema/Electronique_ouverture/schema_Arduino.png
