yacinehrc/L-erreurscope/Images/Schema/Electronique_ouverture/schema_breadboard.png

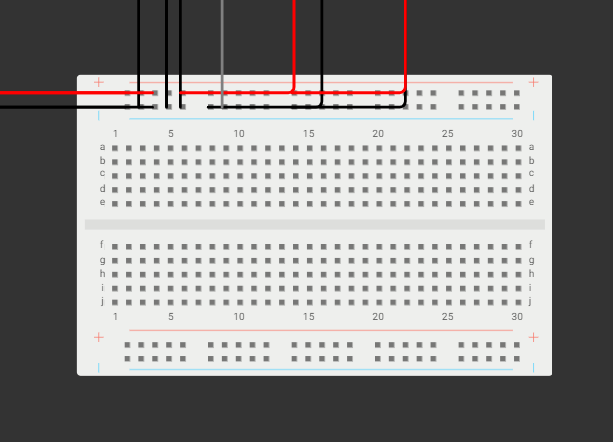
Images/Schema/Electronique_ouverture/schema_breadboard.png
