yacinehrc/L-erreurscope/Images/Schema/Electronique_ouverture/schema_LCD.png

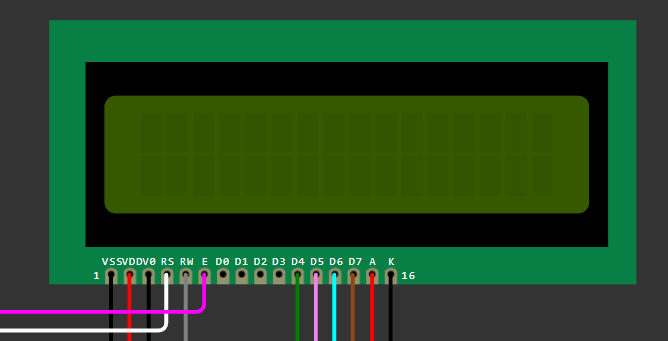
Images/Schema/Electronique_ouverture/schema_LCD.png
