yacinehrc/L-erreurscope/Images/Schema/Electronique_ouverture/schema_RFID-RC522.png

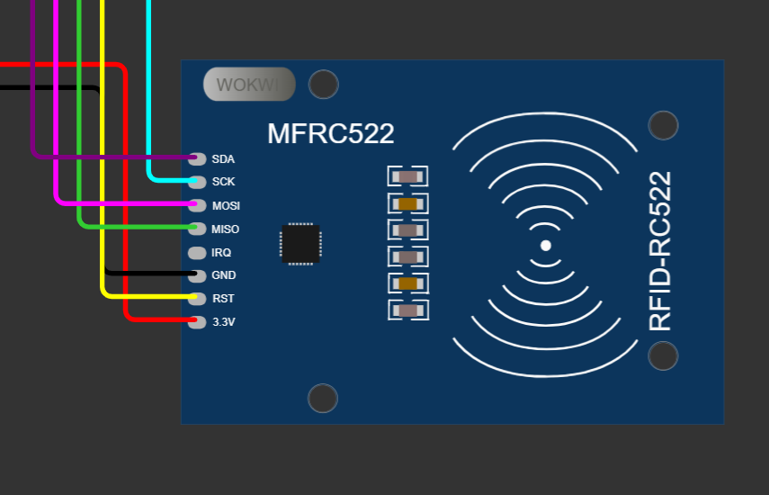
Images/Schema/Electronique_ouverture/schema_RFID-RC522.png
