yacinehrc/L-erreurscope/Images/Schema/Electronique_ouverture/schema_servomoteur.png

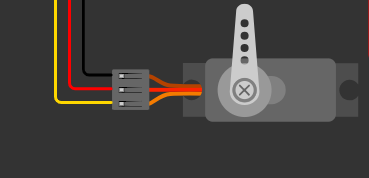
Images/Schema/Electronique_ouverture/schema_servomoteur.png
