yacinehrc/L-erreurscope/Images/Schema/Electronique_ouverture/schéma_LED.png

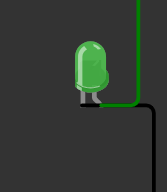
Images/Schema/Electronique_ouverture/schéma_LED.png
