yacinehrc/L-erreurscope/Images/Schema/Raspberry/schema_raspberry.png

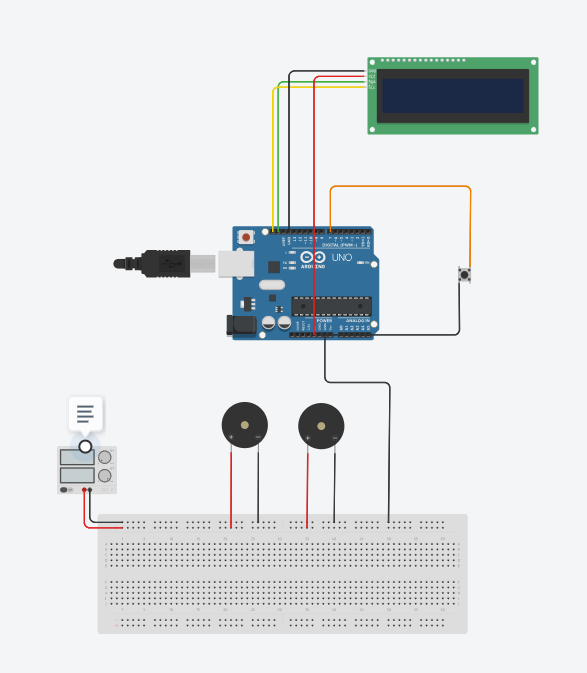
Images/Schema/Raspberry/schema_raspberry.png
