yacinehrc/L-erreurscope/Images/Code/Arduino/fonction_setup.png

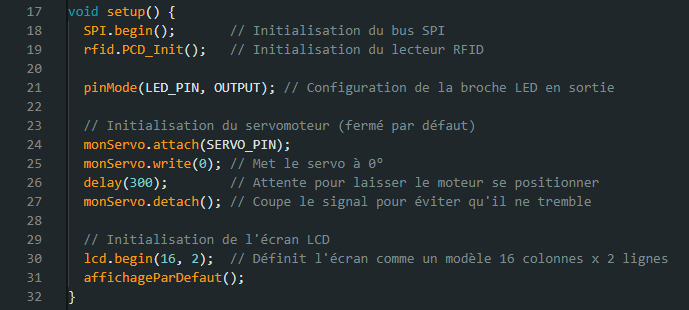
Images/Code/Arduino/fonction_setup.png
