yacinehrc/L-erreurscope/(commit log)

2026-09-15 Ajout de l'arrêt du servomoteur
2026-09-15 Mise à jour de la documentation
2026-09-16 Ajout de l'image de garde
2026-09-16 Mise à jour du code et des commentaires
2026-09-18 Ajout du code Raspberry
2026-09-18 Ajout du schema Raspberry
